open-make/airtrack-doc-website/README.md

# A repository to create a website with a construction guidance for an Airtrack.
## This repository is based on the aquired knowledge in open-make/AIRtrack-rebuilt.
