open-make/airtrack-doc-website/electronic.md

# Electronics part 1: Set up of the wiring

{{BOM}}

## Wiring of devices 

- In order to connect the devices you need a circuit board, e.g. this [circuit board](electronic.yml#circuit_board){Qty:some}. 

- Further you need many jumper wires [jumper wires](electronic.yml#jumper_wires){Qty:many} to set up connections accordingly to the following circuit drawing. You need male, female and ordinary wires. 

- To clean up the pathing of cables you can use cable ties like, e.g. these [cable ties](connectors.yml#cable_tie){Qty:many} and fixate with that the cables at the [aluminium strut profile](framework.yml#20x20Rod).

-  You can use a large breadboard to keep a structure between the [Arduino Uno](electronic.yml#Arduino_Uno){Qty:1}, [capacitive sensor MPR121](electronic.yml#mpr121){Qty:1}, [Active Buzzer](electronic.yml#Keyes_KY-012){Qty:1} and [H bridge L293D](electronic.yml#L293D){Qty:1}.

#### Wiring configuration
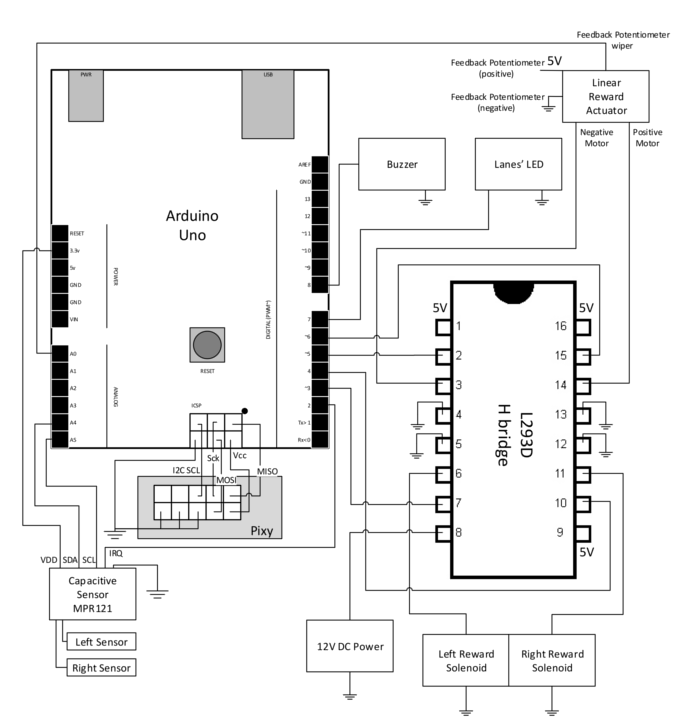
[picture p1: images/arduino_schematic.png]


#### Circuit boards with wiring configuration
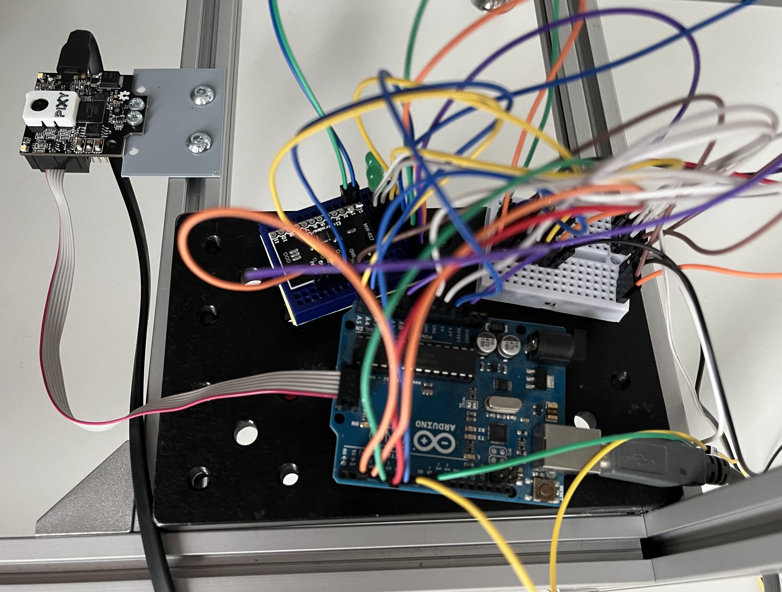
[picture p2: images/circuit.jpg]


### Component informations:

#### [H bridge L293D](electronic.yml#L293D):

- Each connection showing 5V must be connected with a 5V power supply. The Arduino Uno has a 5V power supply.

#### [Linear actuator](electronic.yml#LinActuator50mm):

- Orange cable – Feedback Potentiometer negative reference rail

- Purple cable – Feedback Potentiometer wiper

- Red cable – Motor V+ (6V or 12V)

- Black cable – Motor V- (Ground)

- Yellow cable – Feedback Potentiometer positive reference rail

#### [PixyCam2](electronic.yml#PixyCam)

- You should use the SPI cable to connect the [PixyCam2](electronic.yml#PixyCam) with the Arduino.
    - It should be included in the delivery

- The PixyCam needs to be connected the hole time for power supply

#### 12V Power supply

We used an DIY approach to connect a 12V power supply. It is shown in the picture below:

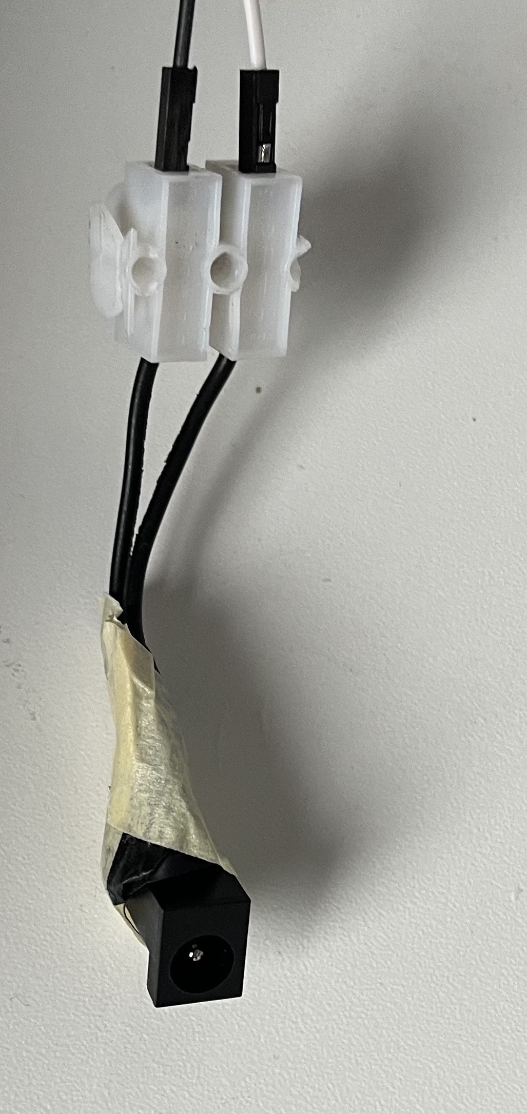
[picture p3: images/power_supply.jpg]


The black ending was removed from another electronic device with a 12V power supply. By this we can connect the power supply with the circuit board via cable.

#### [Capacitive sensor MPR121](electronic.yml#mpr121) 

The left and right sensor in the circuit diagram is meant to be a electrically conductive wire which is attached to each needle.

- The wire needs to be wrapped around the needle multiple times
    - For small changes in the placement of the wire the threshold of the Mpr121 needs to be adjusted. 

- The connections at the MPR121 must be soldered. Therefore you need a small [soldering station](tools.yml#soldering){Qty: 1, Cat: Tool}.

## Not required parts of wiring configuration 

The buzzer and LED in the wiring configuration are components of the first use case and may not be required for your set up. 
Because the provided code is also from the first use case, both components still get mentioned here.
