open-make/airtrack-doc-website/headandcamera.md

# Peripherals part 1: Attaching the camera

This page presents how to set a pixie camera below the setup. The camera should be far enough to record the whole bottom of the air table box. 
{{BOM}}

## 3D print a small plate {pagestep}

- 3D print the following file: 
    - Settings: [i](3D_settings_plate.md)

- Alternatively you can use a 50mm x 30mm x 1,5mm plastic plate.



## Setup / placement {pagestep}
- Place the two [nut](connectors.yml#5mmNuts){Qty:2}s, which are already in the lower center [aluminium strut profile](framework.yml#20x20Rod), with a distance of 35 mm. 

#### Placement of nuts in lower center strut

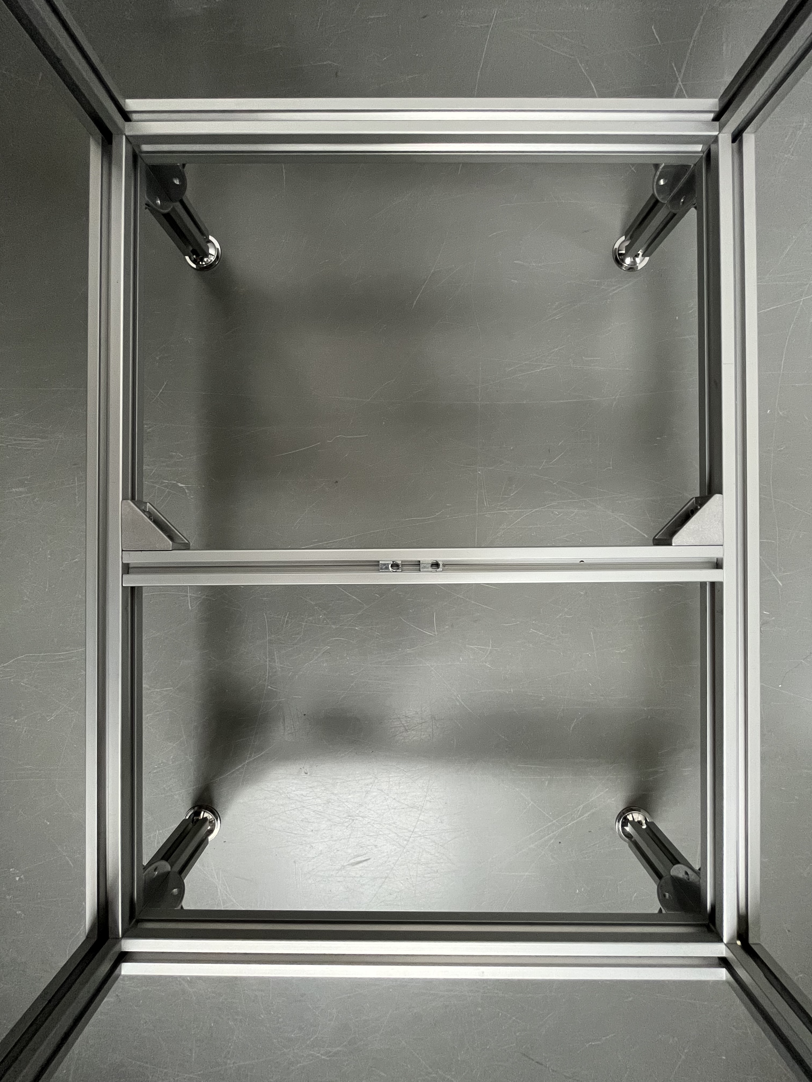
[picture p4: images/camera_below02.jpeg]


- Mark two points with the distance of the threads on the 1.5mm 3D printed plate along one long side with 5 to 10 mm distance from the edge. 

- Drill holes with a [5mm drill](tools.yml#5mmdrill){qty:1, Cat:tool} at both places.

- Take the [Pixy Camera](electronic.yml#PixyCam){qty:1} to mark on the other long side two more drill places with the distance of both holes from the fixation part of the [Pixy Camera](electronic.yml#PixyCam). The distance should be around 7 mm.

- Drill holes with a [3mm drill](tools.yml#3mmdrill){qty:1, Cat:tool} at both places.

- Connect the 3.5mm plate by using [M5 screw (6mm)](screws.yml#m5x6mm_screw){Qty: 2} with the [aluminium strut profile](framework.yml#20x20Rod).

- Connect the [Pixy Camera](electronic.yml#PixyCam) to the 1.5mm plate by using [M3 screw (5mm)](screws.yml#m3x5mm_screw){Qty: 2} and [M3 hexagon nut](screws.yml#m3_hexagon_nuts){Qty: 2}s.

>i **Note** 
>i
>i The [Pixy Camera](electronic.yml#PixyCam) needs to face with the lens away from the side of the table the rewards is provided from to have the assumed orientation of the script.

You might need to shift the [aluminium strut profile](framework.yml#20x20Rod) in the center a bit to have the [Pixy Camera](electronic.yml#PixyCam) in the center.

#### Picture of the below the table placed camera

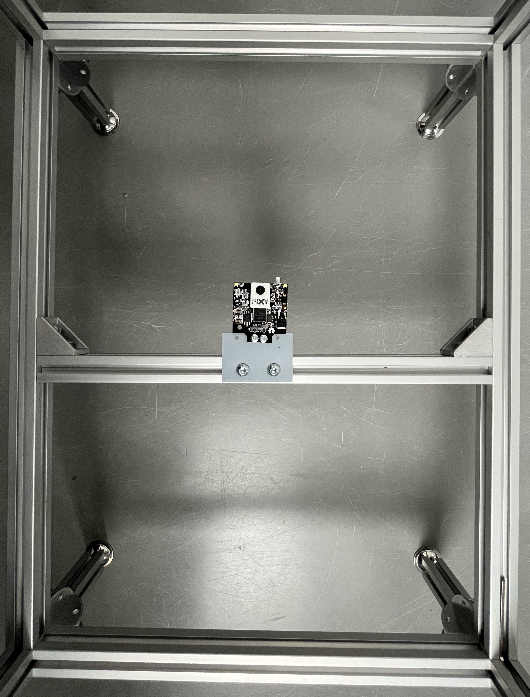
[picture p5: images/camera_below.jpeg]
