open-make/airtrack-doc-website/index.md

# Construct your Airtrack setup !

This website will guide you through the whole process of building an Airtrack setup (large platform version).

The Airtrack was first published in 2016, with a paper titled [Air-Track: a real-world floating environment for active sensing in head-fixed mice](https://doi.org/10.1152/jn.00088.2016).
It was developed by the authors of the paper with the help of the Charité workshop (Alexander Schill).
This documentation website was created by Fabio Reeh and reviewed by Julien Colomb, based on the existing documentation and an own replica.


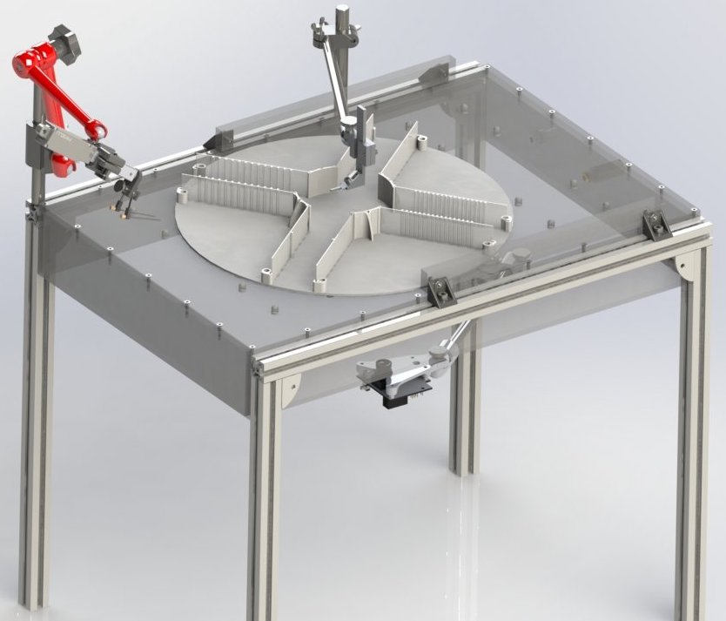
[picture p6: images/airtrack_platform_small.jpg]


This guide is part of the output from the [open.make project](https://www.openmake.de/) (see website for more information, including funding information). This project aims to further establish open hardware in academic research, and support
 scientist in the creation of FAIR research hardware.

## Table of contents

#### [Construction of the airtable](airtable.md){step}

#### [Precut of aluminium profile strut](precut.md){step}

#### [Predrill of plexiglass](predrill.md){step}

#### [Glue and screw](glue.md){step}

#### [Construction of the basic framework](basicframework.md){step}

#### [Insertion of ball valves](ballvalve.md){step}

#### [Air flow and pressure control](air_flow.md){step}

#### [Construction of the peripherals](peripherals.md){step}

#### [Construction of platform tracking](headandcamera.md){step}

#### [Construction of linear actuator front](actuator_head.md){step}

#### [Construction of the rewarding system](rewardsystem.md){step}

#### [Construction of the head fixation](headfixation.md){step}

#### [Floating platform](3Dprinting.md){step}

#### [Setup of the electronics](setup_electronic.md){step}

#### [Setup of the wiring](electronic.md){step}

#### [Installation of scripts](script_setup.md){step}

#### [Configuration of PixyCam](PixyCamConfig.md){step}

#### [Arduino code guide](code_usage.md){step}

#### [List of all necessary components]{BOM}

## About the Airtrack

To investigate the neuronal activities in ordinary behaviour, it's eligible to implement modern brain recording equipment.
These modern technics frequently require head fixation.
The Airtrack is one approach to facilitate analysing natural behaviour in its complexity.
Behaviour is depended on permanent sensory feedback from various modalities and to provide the possibility of sensory perception in its totality is a central challenge.
The Airtrack aims to facilitate these multiple sensory and motor modality approaches in combination with a simple setup, low costs and less computational processing.
The shift from a virtual visual (air ball/ treadmill with VR) to somatosensory modality approach causes a natural tactile representation while having less computational needs besides no errors between perception and movement of the mice and corresponding virtual environment.
The virtual environment approaches faces the difficulties of estimating the perceptual experience of the mice or other animals and it's probably impossible to match virtual reality and real world experience. 
The developers conclude that the Airtrack system is ideal for eliciting natural behaviour in concert with virtually any system for monitoring or manipulating brain activity.

The Airtrack was used to perform Go/No-Go and two-alternative forced choice tasks with mice.

As the system is in use within Larkum Lab and gets developed, we encourage you to check the recent publications to see new variants and applications.

## Overview of the setup

The airtrack system consists out of a central air table with the possibility of modification.
In this version, a mouse moves on a floating lightweight plus maze, while being head fixed in the center above the platform.
Below the table a camera tracks the movement of the plus maze with different coloring on the bottom side of the platform.
At one side of the table a moveable reward system is placed with two licking spots.
To detect if a spot was licked, a capacitive sensor is used.

The lanes on the maze are equipped with different features to distinguish them and correspond with the tasks. They can either be smooth or with gratings etched.
Further for the performed tasks, a LED and buzzer are installed to provide position feedback.
The position tracking was done with a Pixy camera (CMUcam5 Image Sensor) by detecting  different colouring on the bottom side of the plus maze.

The central table consists out of a plexiglass box with air flowing through. On the upper side many holes are placed to create an air cushion on the surface the platform can float on.
The table is mounted on aluminium legs to reach the desired height and space for the camera.
On the framework is a lot space to place e.g. further tracking devices.
The computational tasks are performed with a Arduino Uno microcontroller.

## Size and struts

The amount of strut profiles you need depends on the hight of the table, and how well you can cut the 2 m strut profiles into pieces. For the default table (height = 400 mm) it takes 6m (= 3 pieces). It is best practice to have more than you actually need, such that you get spares if the struts are incorrectly cut. 



### Download STEP file of hole Airtrack

The STL file above and the CAD files of the ZIP folder contain partly different components. The main changes:

- Platform borders
- Headfixation
- Camera mount
- No second framework ring

>i **Download** 
>i
>i Download all available CAD files and extra documents:
>i
>i Contains: STL file, CAD Parasolid file, CAD for SolidWorks viewer, STEP file, PDF with some technical aspects
>i
>i
>i [ZIP file](airtable_480x366.zip)
>i
>i **Note** 
>i
>i The STL and STEP files vary in the used components at some places to this guide

### Disclaimer: Construction complexity

Some parts are more difficult to construct than others. Mainly the central plexiglass box is difficult to build with an improvised work place. Precise cutting of the plexiglass is needed to ensure airtight manufacturing. Further, a workshop might use UV glue for the box which provides a higher quality.

If you have access to a workshop, we recommend you to get the air table constructed there. In general, it's better to have a large fraction of the Airtrack manufactured professionally. 

### Disclaimer: Arduino code complexity

I order to fully use the Airtrack, you need to debug and write code for the Arduino. The provided code works but you need to adjust it at some places to adapt it to your circumstances. 

### Advice: Further development

If you want to use the base hardware of the Airtrack and want to use it for other research questions, we recommend you to have a good understanding of the Arduino and possible peripherals. Besides you need sufficient coding experience with C++ (mostly used) to develop a good working code. 

References: [Nashaat MA, Oraby H, Sachdev RN, Winter Y, Larkum ME. Air-Track: a real-world floating environment for active sensing in head-fixed mice. J Neurophysiol. 116(4):1542-1553, 2016](https://pubmed.ncbi.nlm.nih.gov/27486102/)

#### Latest change: 24.10.2024
