open-make/airtrack-doc-website/headfixation.md

# Peripherals part 4: Construction of the head fixation 

For the observations the animal's head needs to be fixated above the center of the platform and therefore a head fixation method is required. This section is less detailed because you need to take your setup into account. Here we offer a solution which is basic and might work on your side. You can take this as an idea for the general basic structure if you design it yourself. In generell, we can recommend Thorlabs for ordering equipment.  

{{BOM}}

## Head fixation requirements

- Keep the head in one position centered above the table.
- The mouse needs to touch the ground in order to move the platform.

## Placing vertical mounting {pagestep}

- Place one free [nut](connectors.yml#5mmNuts) in each 480 mm [aluminium strut profile](framework.yml#20x20Rod){qty:2} of the [center air table](fromstep){Qty:1}, pointing upwards. 
     - The nut was placed in the step "Construction of the rewards system"

- Move the nuts to the center of the two 480 mm [aluminium strut profiles](framework.yml#20x20Rod).

- Place in each central nut one of the [M5 rods](framework.yml#M5Rod){Qty:2}. Attach on each [M5 rod](framework.yml#M5Rod) a [connecting clamp](connectors.yml#12mmCC){Qty:2} 150 mm  above the table. 

## Attaching the head fixation {pagestep}

- Turn both [connecting clamps](connectors.yml#12mmCC) on  the upwards pointing rods in a 90 degree angle. 

- Cut a 380 mm long piece of an  [aluminium rod 12mm diameter](framework.yml#12mmRod){Qty:1} with a [metall saw](tools.yml#metallsaw){Qty:1, cat: tool}, and place it in both [connecting clamps](connectors.yml#12mmCC) on the upwards pointing rods. On this rod attach the headfixation.

If the head fixation system you have is incompatible with this construction, a placement on the vertical [M5 thread rod](framework.yml#M5Rod) might work.

#### Picture of the rod above the table for the headfixation

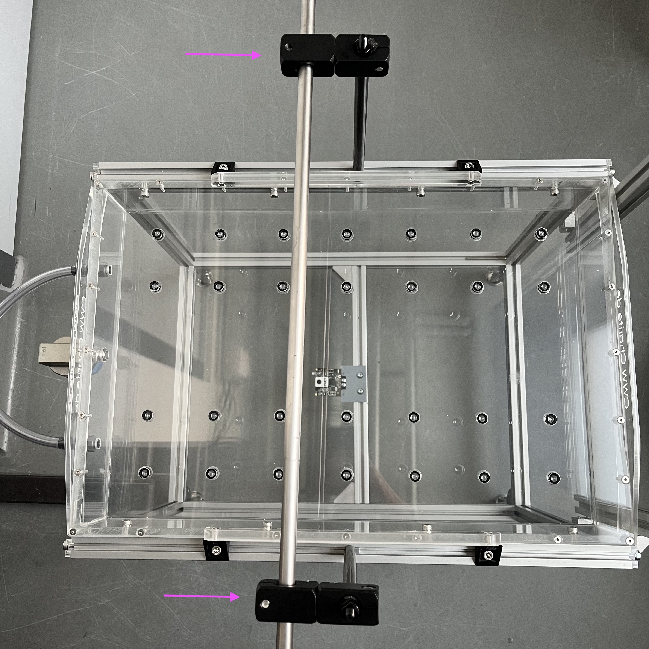
[picture p14: images/headfixation.jpeg]
