open-make/airtrack-doc-website/3D_settings_plate.md

# 3D print settings:

- Layer height: 0.2 mm 
- Infill: 60 % 
- Support: No
- Raft: if needed
