open-make/airtrack-doc-website/airtrack_platform.jpg

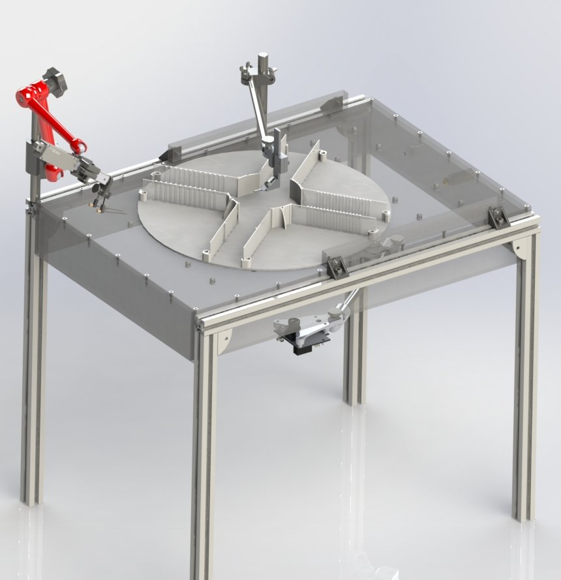
airtrack_platform.jpg
