open-make/airtrack-doc-website/images/desc_02.jpeg

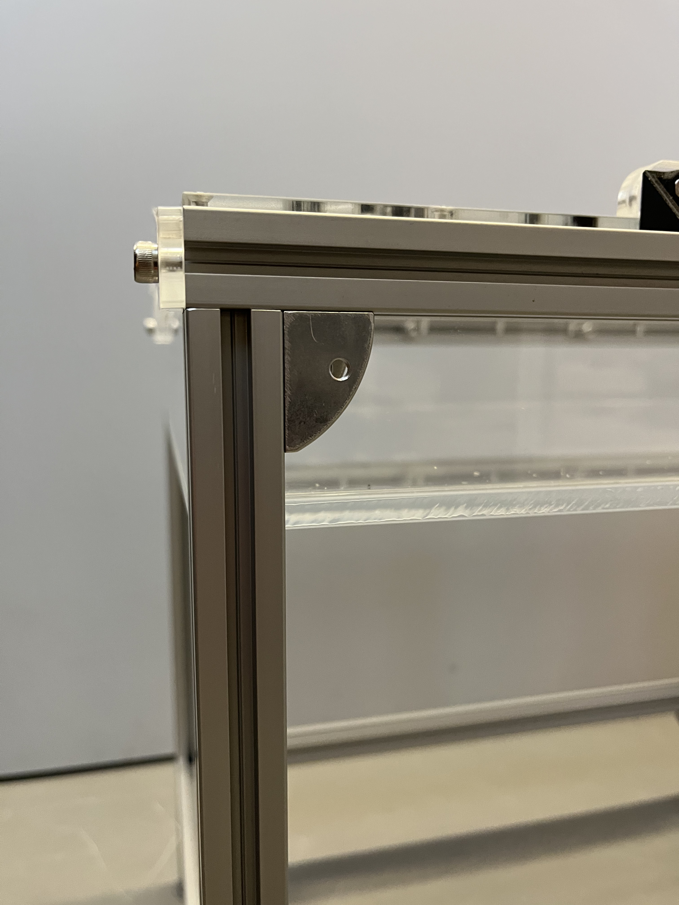
images/desc_02.jpeg
