open-make/airtrack-doc-website/images/desc_03.jpeg

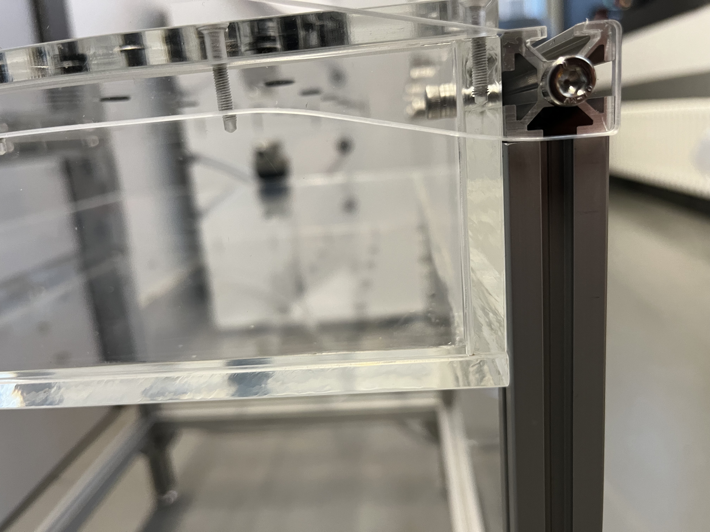
images/desc_03.jpeg
