open-make/airtrack-doc-website/images/desc_04.jpeg

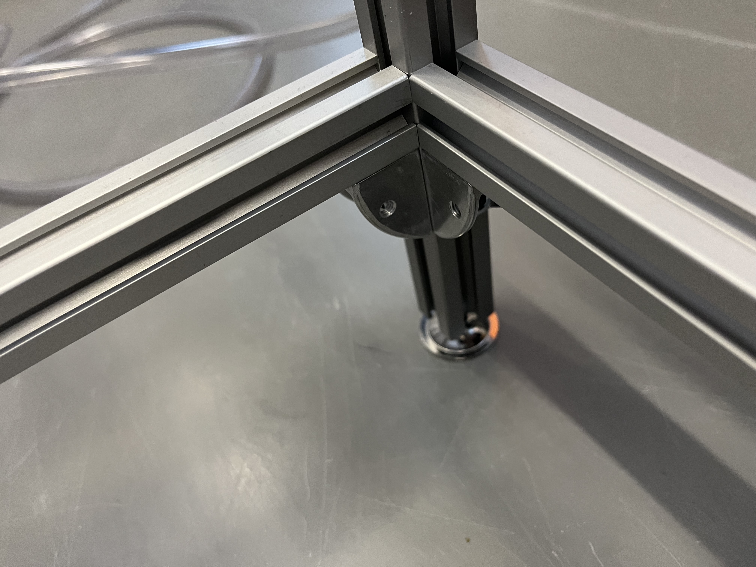
images/desc_04.jpeg
