open-make/airtrack-doc-website/images/platform_01.jpg

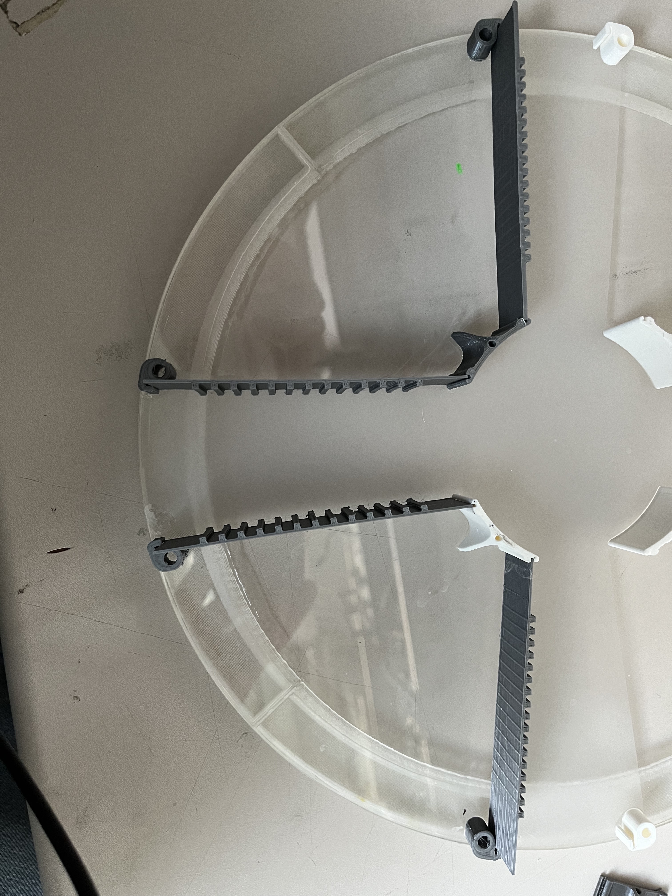
images/platform_01.jpg
