open-make/airtrack-doc-website/images/Top_plexiglas_drill_distances.jpeg

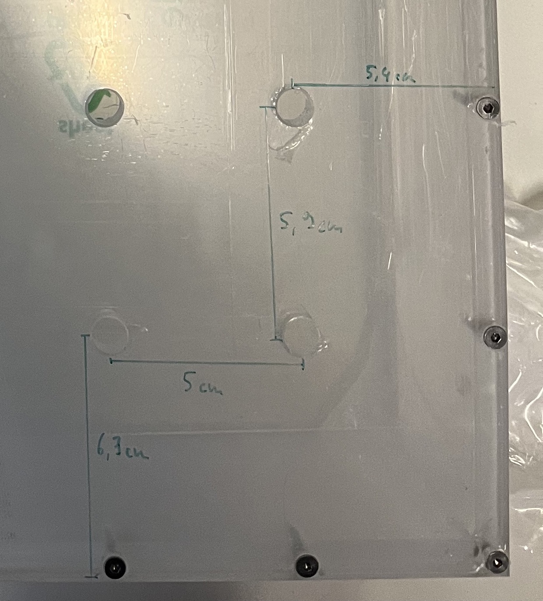
images/Top_plexiglas_drill_distances.jpeg
