open-make/airtrack-doc-website/models/ball_sleeve.stl

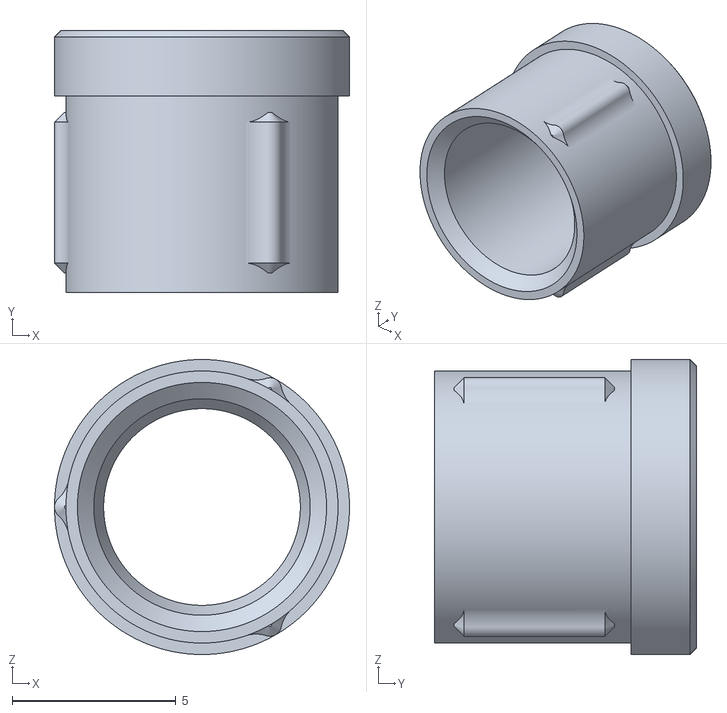
[picture p30: CAD file, 2024-09-29]
models/ball_sleeve.stl
9.00 x 8.00 x 9.00
