open-make/airtrack-doc-website/models/ball_fixation001.stl

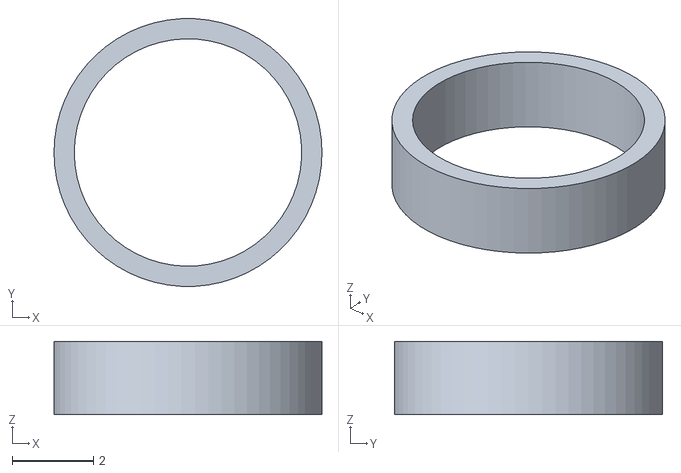
[picture p31: CAD file, 2024-09-29]
models/ball_fixation001.stl
6.60 x 6.59 x 1.80
