open-make/airtrack-doc-website/models/1_5mm_plate.stl

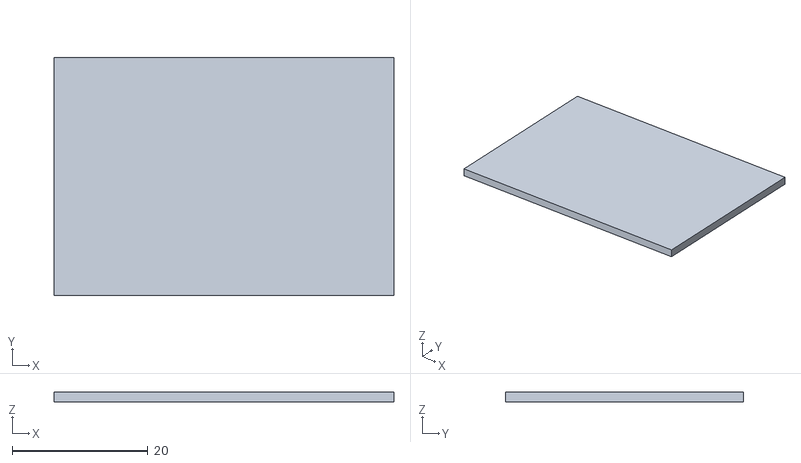
[picture p32: CAD file, 2023-10-10]
models/1_5mm_plate.stl
50.0 x 35.0 x 1.50
