open-make/airtrack-doc-website/models/l_maze_quarter_ground.stl

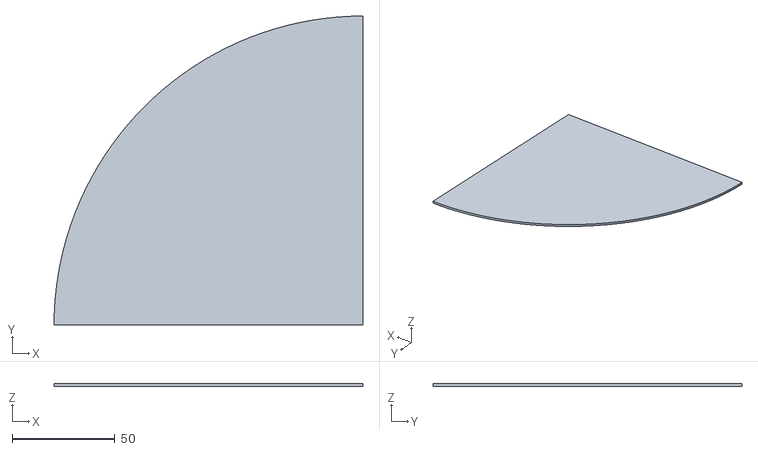
[picture p33: CAD file, 2023-09-13]
models/l_maze_quarter_ground.stl
150.0 x 150.0 x 1.50
