open-make/airtrack-doc-website/models/3_5mm_plate.stl

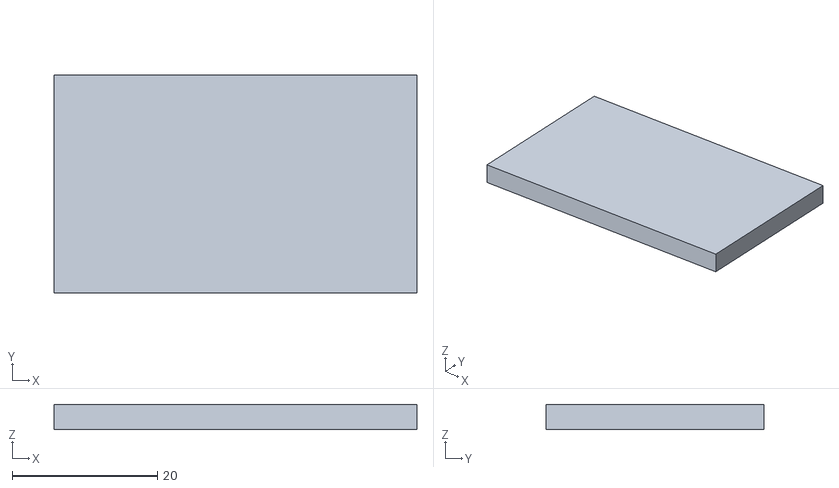
[picture p34: CAD file, 2023-06-09]
models/3_5mm_plate.stl
50.0 x 30.0 x 3.50
