open-make/airtrack-doc-website/models/rewards_moveable_needle_hold.stl

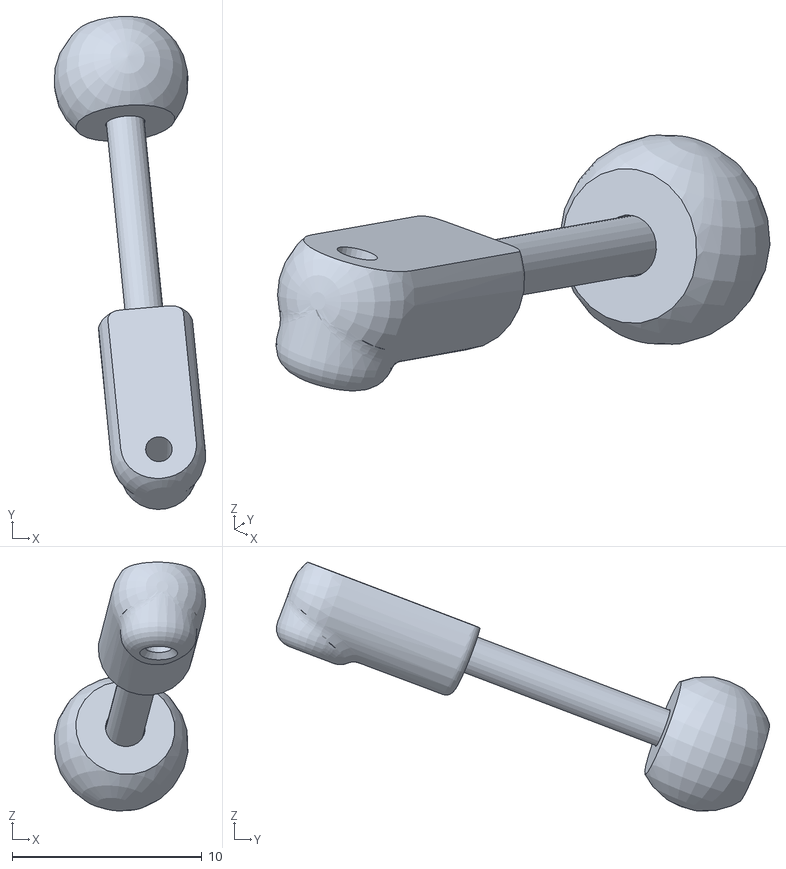
[picture p35: CAD file, 2023-06-09]
models/rewards_moveable_needle_hold.stl
7.96 x 26.0 x 13.1
