open-make/airtrack-doc-website/models/rewards_needle_fixation.stl

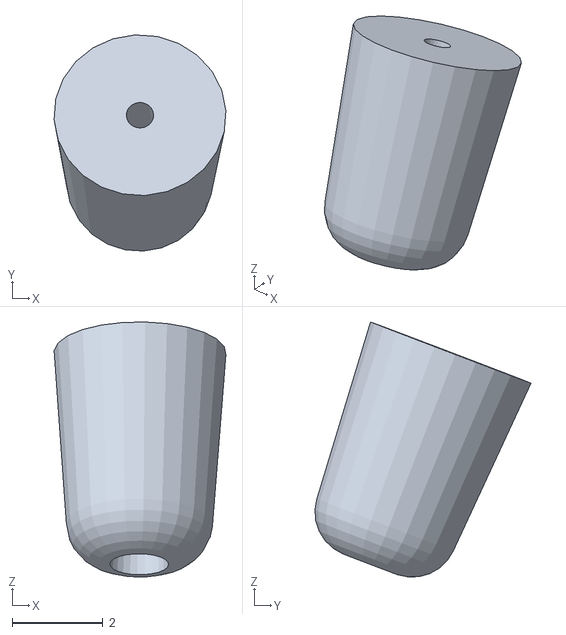
[picture p36: CAD file, 2023-06-09]
models/rewards_needle_fixation.stl
3.79 x 4.77 x 5.63
