open-make/airtrack-doc-website/models/rewards_mnh_end_02.stl

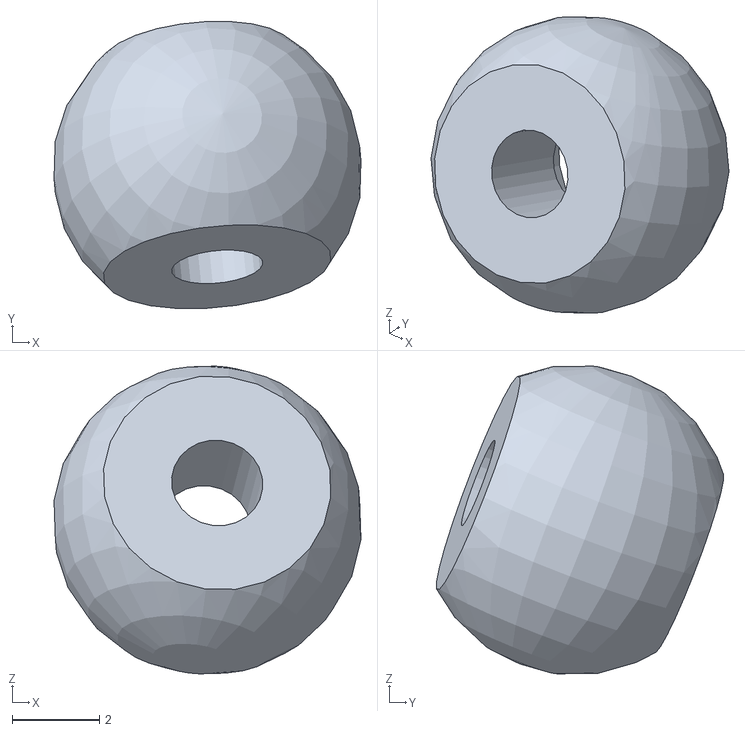
[picture p37: CAD file, 2023-06-09]
models/rewards_mnh_end_02.stl
7.03 x 6.57 x 7.04
