open-make/airtrack-doc-website/models/rewards_all.stl

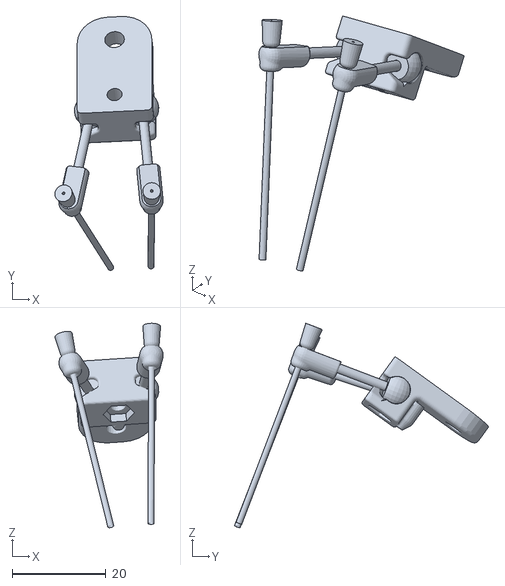
[picture p38: CAD file, 2023-06-09]
models/rewards_all.stl
23.1 x 54.2 x 43.7
