open-make/airtrack-doc-website/models/rewards_mnh_end_01001.stl

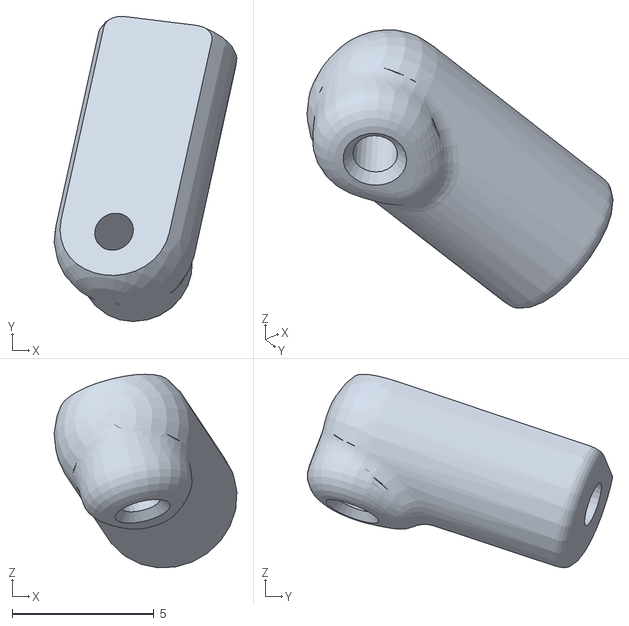
[picture p39: CAD file, 2023-06-09]
models/rewards_mnh_end_01001.stl
6.44 x 10.7 x 6.82
