open-make/airtrack-doc-website/models/rewards_center_01.stl

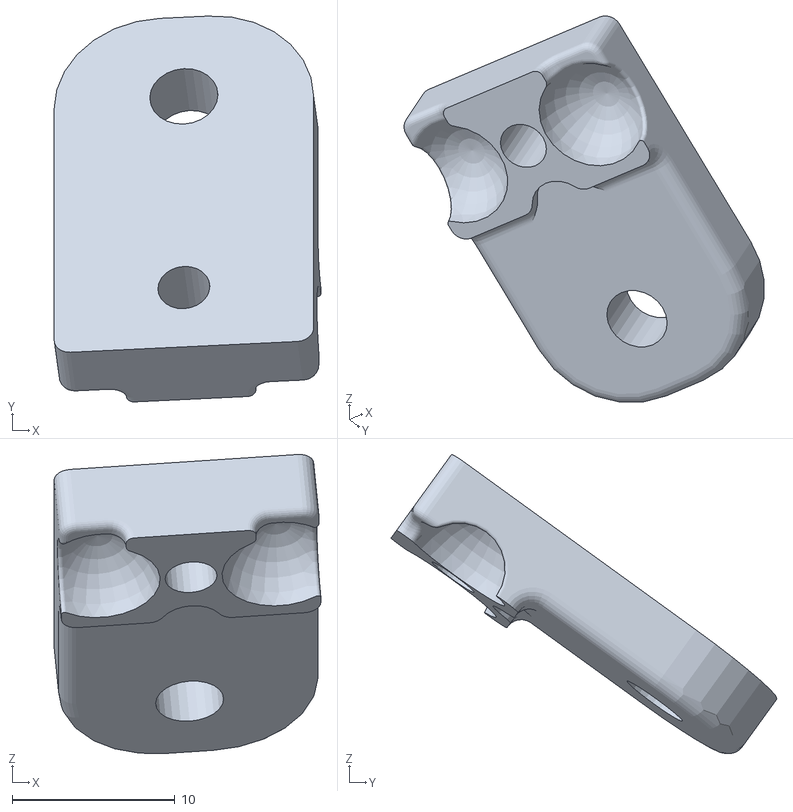
[picture p40: CAD file, 2023-06-09]
models/rewards_center_01.stl
16.4 x 23.7 x 18.4
