open-make/airtrack-doc-website/models/rewards_center_02.stl

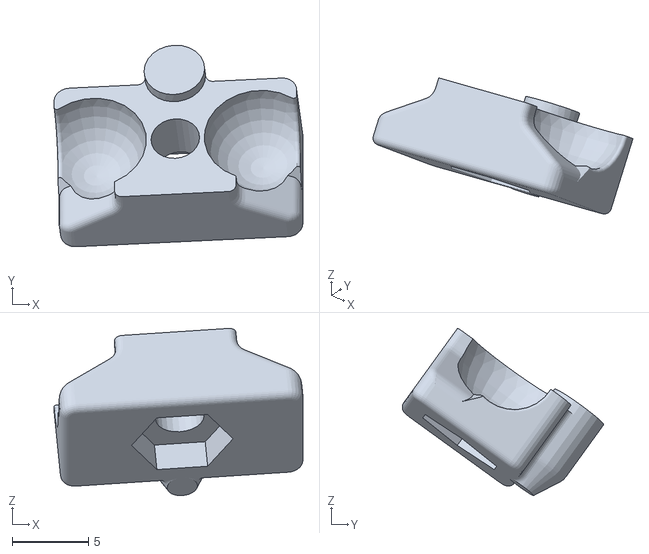
[picture p41: CAD file, 2023-06-09]
models/rewards_center_02.stl
16.4 x 13.2 x 11.0
