open-make/airtrack-doc-website/models/s_Maze_X_ground.stl

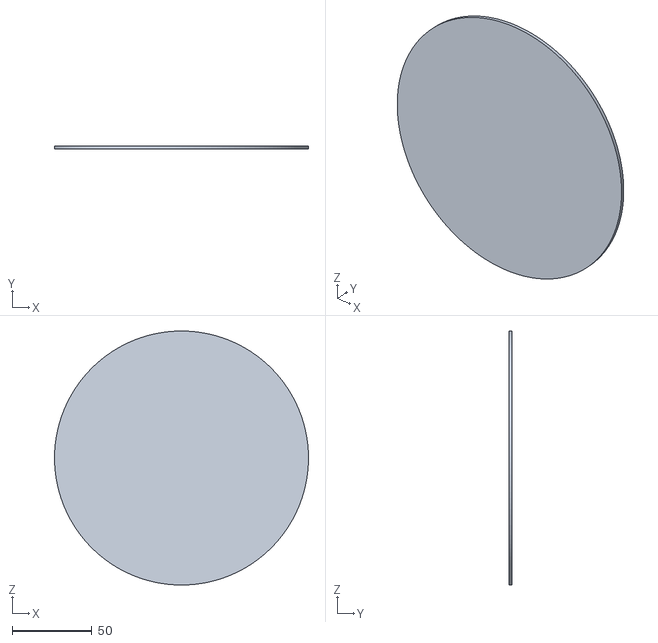
[picture p42: CAD file, 2023-01-26]
models/s_Maze_X_ground.stl
159.0 x 2.00 x 159.0
