open-make/airtrack-doc-website/models/s_Maze_walls.stl

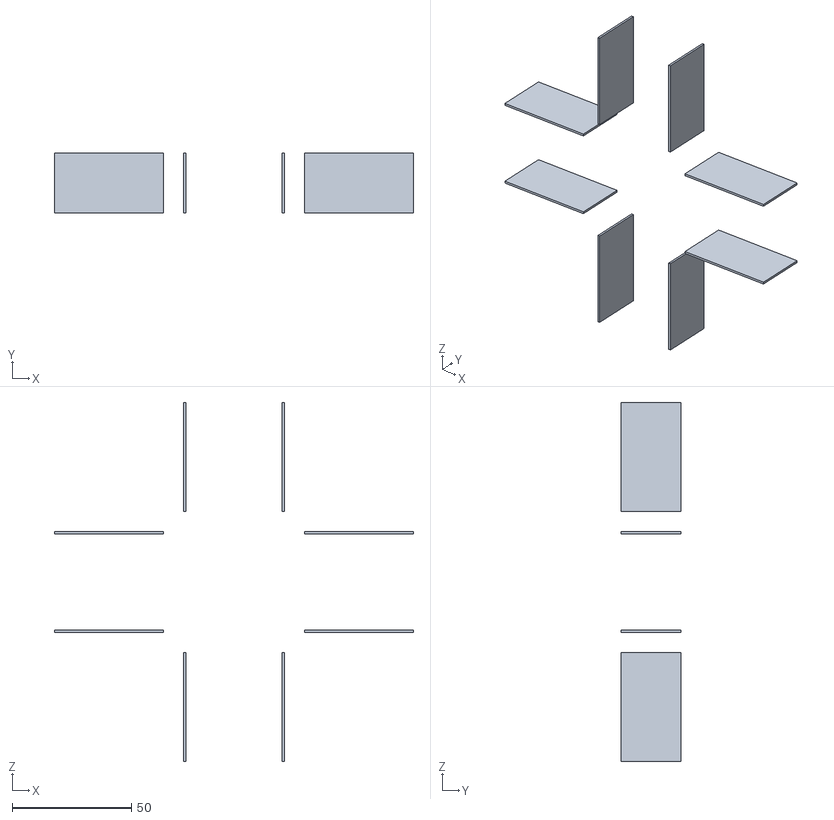
[picture p43: CAD file, 2023-01-26]
models/s_Maze_walls.stl
150.2 x 25.0 x 150.2
