open-make/airtrack-doc-website/models/l_Maze_X_wallmount.stl

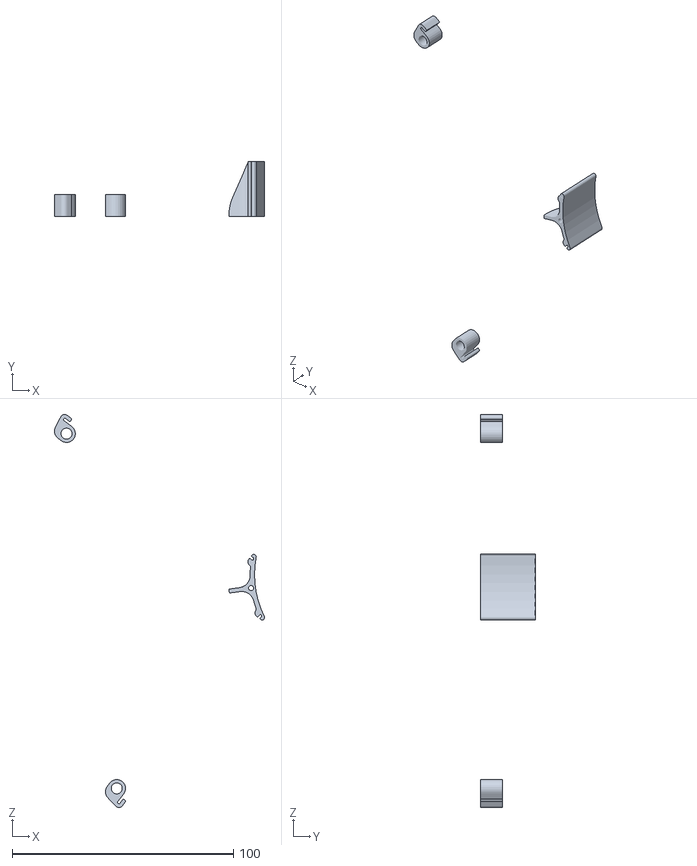
[picture p44: CAD file, 2023-01-26]
models/l_Maze_X_wallmount.stl
95.1 x 25.0 x 177.8
