open-make/airtrack-doc-website/models/s_Mazewall_mount.stl

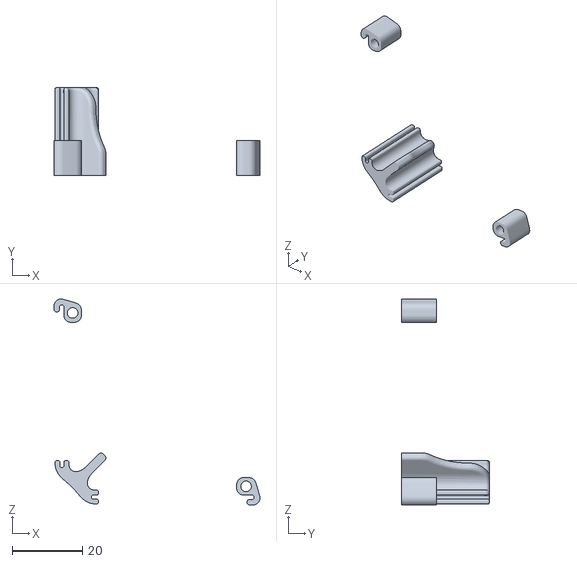
[picture p45: CAD file, 2023-01-26]
models/s_Mazewall_mount.stl
58.6 x 25.0 x 58.6
