open-make/airtrack-doc-website/models/s_Maze_X_rim.stl

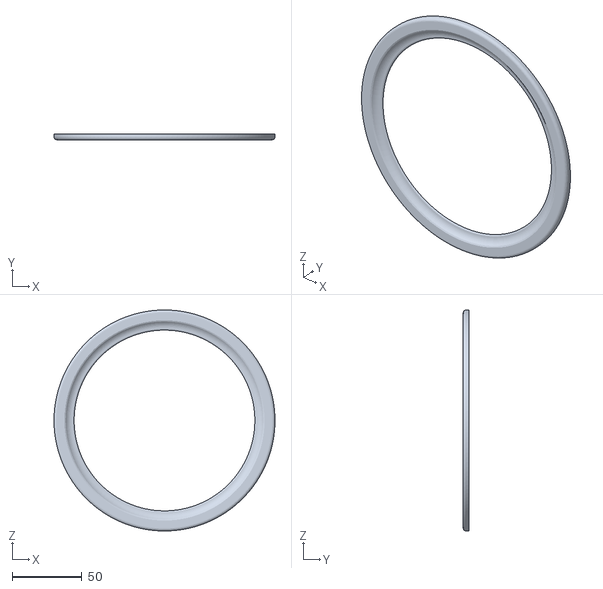
[picture p46: CAD file, 2023-01-26]
models/s_Maze_X_rim.stl
159.0 x 4.00 x 159.0
