open-make/airtrack-doc-website/models/s_Maze_X_all.stl

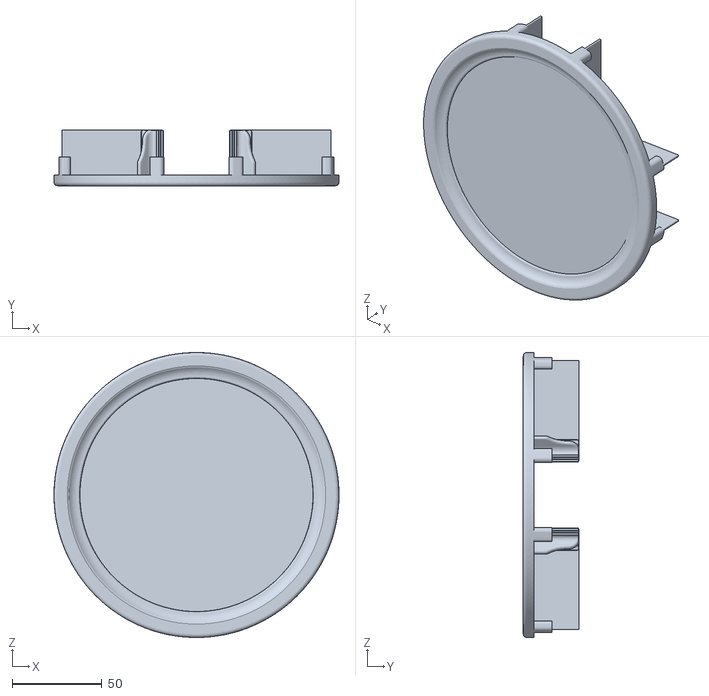
[picture p47: CAD file, 2023-01-23]
models/s_Maze_X_all.stl
159.0 x 31.0 x 159.0
