open-make/airtrack-doc-website/models/l_Maze_X_ground.stl

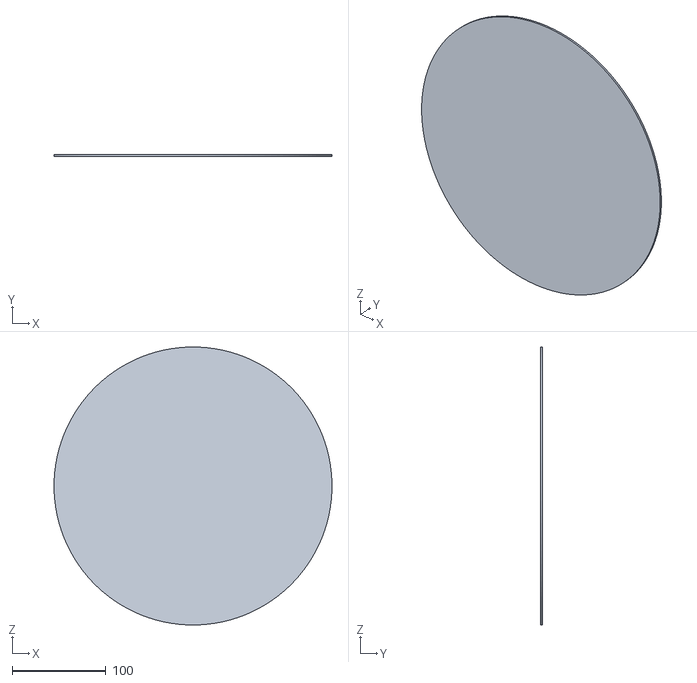
[picture p48: CAD file, 2023-01-23]
models/l_Maze_X_ground.stl
297.0 x 2.00 x 297.0
