open-make/airtrack-doc-website/models/l_Maze_all.stl

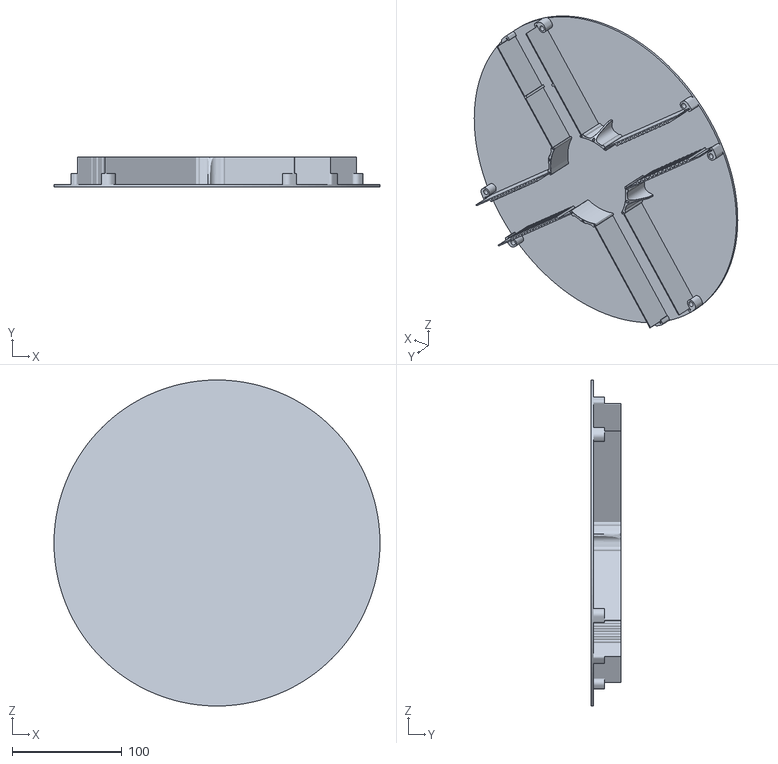
[picture p49: CAD file, 2023-01-23]
models/l_Maze_all.stl
297.0 x 27.0 x 297.0
