open-make/airtrack-doc-website/models/l_Maze_X_all_02.stl

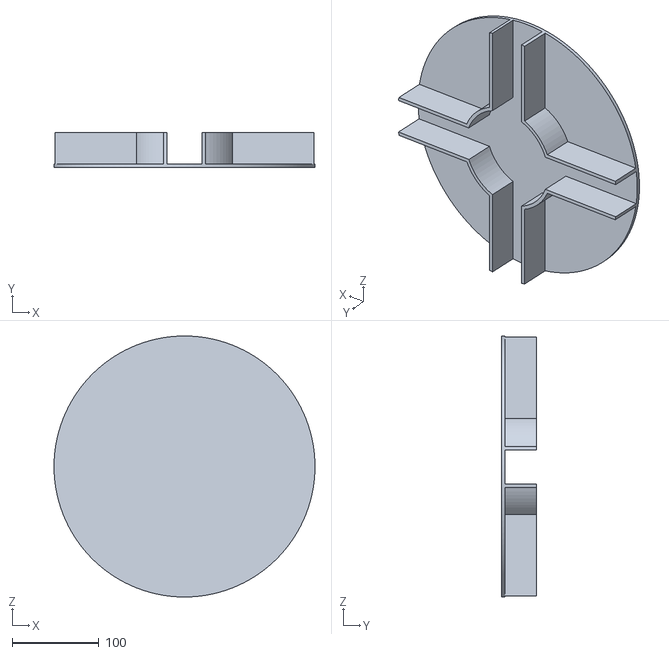
[picture p50: CAD file, 2023-01-23]
models/l_Maze_X_all_02.stl
300.0 x 40.0 x 300.0
