open-make/airtrack-doc-website/models/l_Maze_X_walls.stl

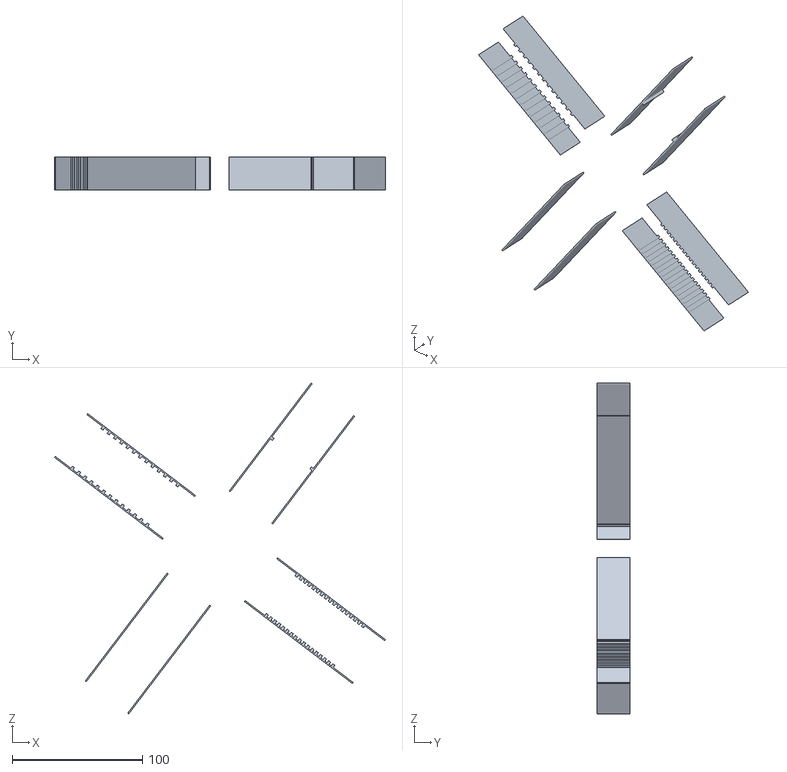
[picture p51: CAD file, 2023-01-23]
models/l_Maze_X_walls.stl
253.9 x 25.0 x 253.8
