open-make/airtrack-doc-website/setup_electronic.md

# Set up of the electronics

For full functionality a program is needed to control the devices and manage their actions in time. Before you need to connect the electronic devices and configure some settings. Some of the settings depend on circumstances on your side and parameters need to be evaluated by you.

## Wiring {pagestep}

Follow the [instruction](electronic.md) to connect the devices with the Arduino via circuit board.

## Uploading scripts {pagestep}

Follow the [instruction](script_setup.md) to upload the scripts to the Arduino.

## PixyCam configuration {pagestep}

Follow the [instruction](PixyCamConfig.md) to configure the PixyCam.

## Program {pagestep}

Read the [instruction](code_usage.md) to learn aspects of the scripts.
