open-make/airtrack-doc-website/guide_toDo.tsv

To do | Description | Done?
Angle | check at the workshop for the product info of the angles
Ball ventile | check at the workshop for the product info of the used ball ventiles
PixyCam Mount | Design 3D print | y
Linear Acuator | Design 3D print for front and back | y
licking spots | details needed | y
rewards supply | where to place the storage of rewads
