open-make/airtrack-doc-website/Constructional_drawing/short_sides_01.png

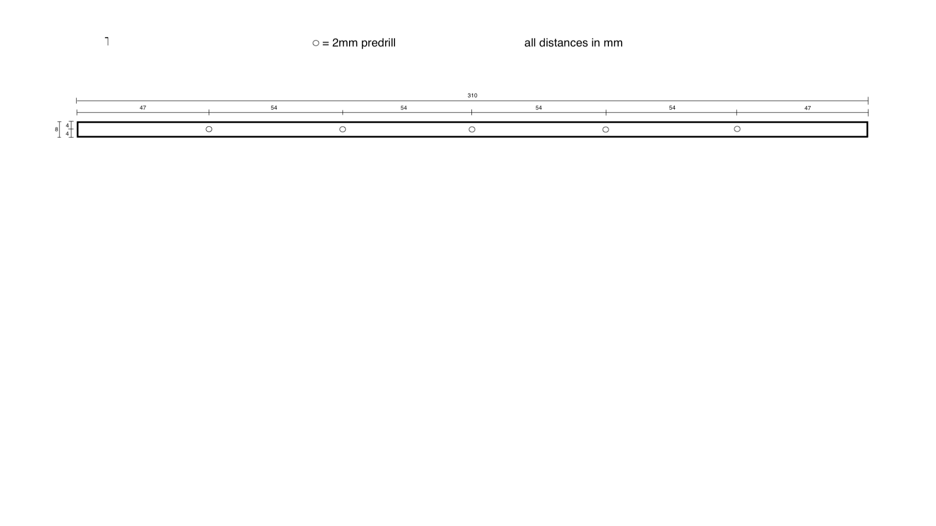
Constructional_drawing/short_sides_01.png
