open-make/airtrack-doc-website/Constructional_drawing/side_plates.png

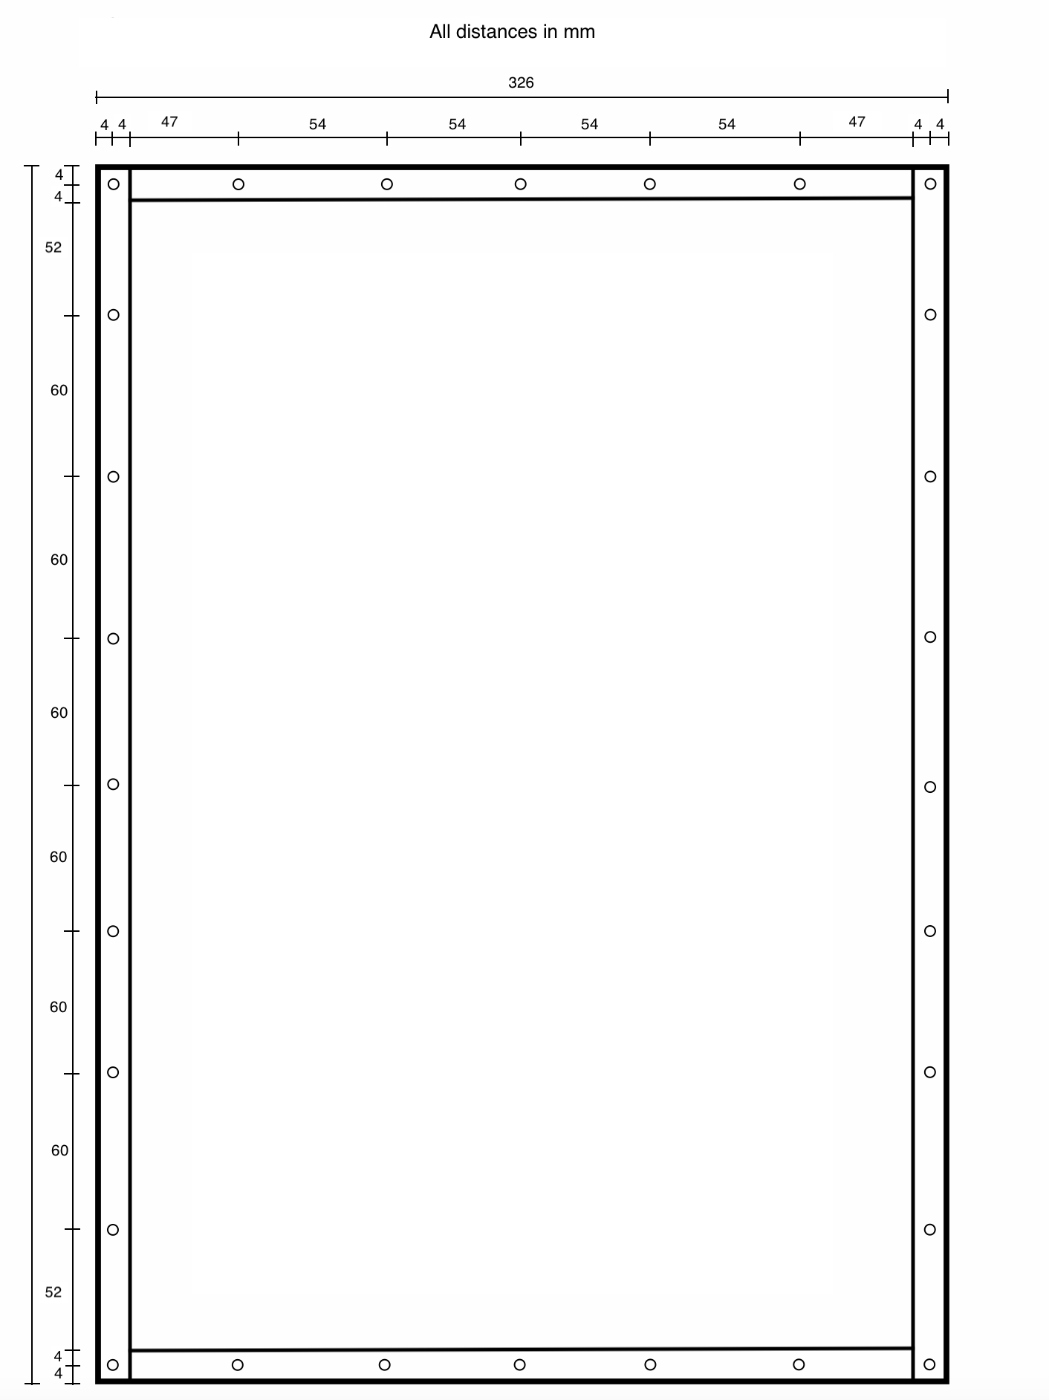
Constructional_drawing/side_plates.png
