open-make/airtrack-doc-website/(threads)

Thread 1 (2023-03-30):

todo list air track doc

jcolomb, 2023-03-30:
HARDWARE QUESTIONS
- [x] mpr placement + detectors placement + licking spots
- [x] pixy cam mount (extra 3d printing)
- [x] find a stable clamp for actuator
- [x] get info from workshop
     - balls and cylinder for balls
- [x] check English
- [x] better structure (group information in a way),  sub structure toc
- [x] review where we need (good) pictures

Closed 2024-05-08.

Thread 4 (2023-07-21):

to do

FabioReeh, 2023-07-21:
- [x] check order of logic (everywhere) -> glue bottom plate
- [ ] sub structure toc
- [x] disclaimer workshop append
- [x] every time use mm
- [x] why picture and wherefore -> caption
- [x]  add full length of frame
- [x] cutting guide frames and from this the amount

jcolomb, 2023-09-19:
moving to new todo

Closed 2023-09-19.

Thread 5 (2023-08-13):

to do

FabioReeh, 2023-08-13:
- [x] ground color
- [x] needle
- [x] head fixation
- [x] captions
- [x] 2nd variant plattform
- [x] reward liquid storage description

Closed 2023-11-14.
