open-make/airtrack-doc-website/plexiglass.yml

480x326pg:
    Name: (cast) acrylic glass sheet precut
    Description: 480mm x 326mm x 8mm
    Specs:
        Material: Polymethylmethacrylat



480x64pg:
    Name: (cast) acrylic glass sheet precut
    Description: 480mm x 64mm x 8mm
    Specs:
        Material: Polymethylmethacrylat



310x64pg:
    Name: (cast) acrylic glass sheet precut
    Description: 310mm x 64mm x 8mm
    Specs:
        Material: Polymethylmethacrylat

520x40pg:
    Name: (cast) acrylic glass sheet precut
    Description: 520mm x 40mm x 8mm
    Specs:
        Material: Polymethylmethacrylat

250x15pg:
    Name: (cast) acrylic glass sheet precut
    Description: 250mm x 15mm x 8mm
    Specs:
        Material: Polymethylmethacrylat

286x30pg:
    Name: (cast) acrylic glass sheet precut
    Description: 286mm x 30mm x 8mm
    Specs:
        Material: Polymethylmethacrylat

326x30pg:
    Name: (cast) acrylic glass sheet precut
    Description: 286mm x 30mm x 8mm
    Specs:
        Material: Polymethylmethacrylat

350x30pg:
    Name: Plexiglass precut
    Description: 350mm x 30mm x 8mm
    Specs:
        Material: Polymethylmethacrylat

366x30pg:
    Name: (cast) acrylic glass sheet precut
    Description: 366mm x 30mm x 8mm
    Specs:
        Material: Polymethylmethacrylat

r300mmpg:
    Name: Circular (cast) acrylic glass sheet precut
    Description: Diameter 300mm and height 4mm
    Specs:
        Material: Polymethylmethacrylat

ball:
    Name: Acrylic glass  
    Description: Acrylic glass XT ball, transparent, solid, diameter 6.4mm 
    Specs:
        Material: Acrylic glass 
    Suppliers:
        Modulor:
            PartNo: 0250311
            Link: 'https://www.modulor.de/en/acrylic-glass-xt-ball-transparent-solid-o-6-4-mm-oxid.html'
