open-make/airtrack-doc-website/(commit log)

2023-01-26 error fix
    [LMazeGroundandWall02_1.stl, PlusMazeWithoutWalls.stl, SMazeWithWalls.stl, SMazeWithoutWalls.stl, l_Maze X ground.stl, l_Maze X wall mount.stl, l_Maze all.stl, l_Maze x all 02.stl]
2023-06-09 push work
    [3_5mm_plate.stl, guide_toDo.tsv, rewards_all.stl, rewards_center_01.stl, rewards_center_02.stl, rewards_mnh_end_01.stl, rewards_mnh_end_01001.stl, rewards_mnh_end_02.stl]
2023-07-16 review drill and gluing
2023-07-16 review drill and gluing 2
2023-07-19 changing table of content and review framework and co...
2023-11-14 review started- until glue
2024-09-29 Add pictures and adjust pinch valves / tubes
    [ball_fixation.stl, ball_fixation001.stl, ball_sleeve.stl, ball_sleeve001.stl]
2024-10-17 Added pixy arduino library
2024-10-17 firewall Arduino ide note
