open-make/airtrack-doc-website/images/desc_06.jpeg

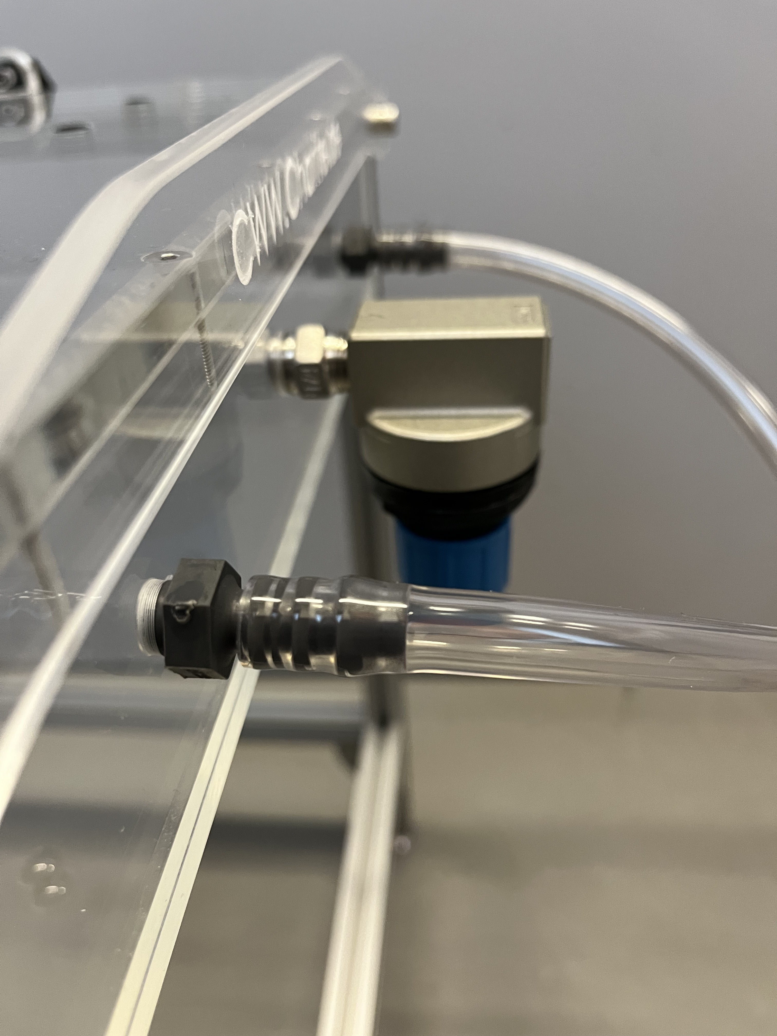
[picture p11: images/desc_06001.jpeg]
images/desc_06.jpeg
