open-make/airtrack-doc-website/images/desc_01.jpeg

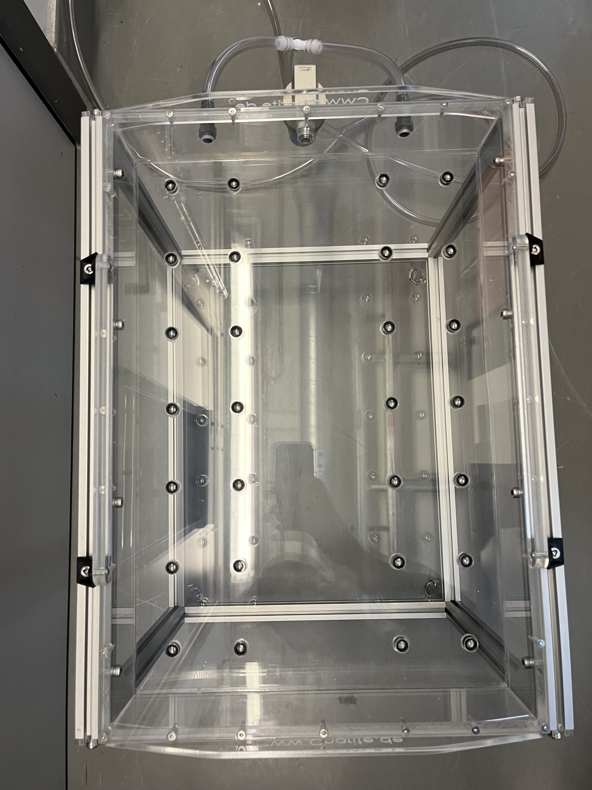
images/desc_01.jpeg
