open-make/airtrack-doc-website/images/Top_plexiglas_drill_distances_all.jpeg

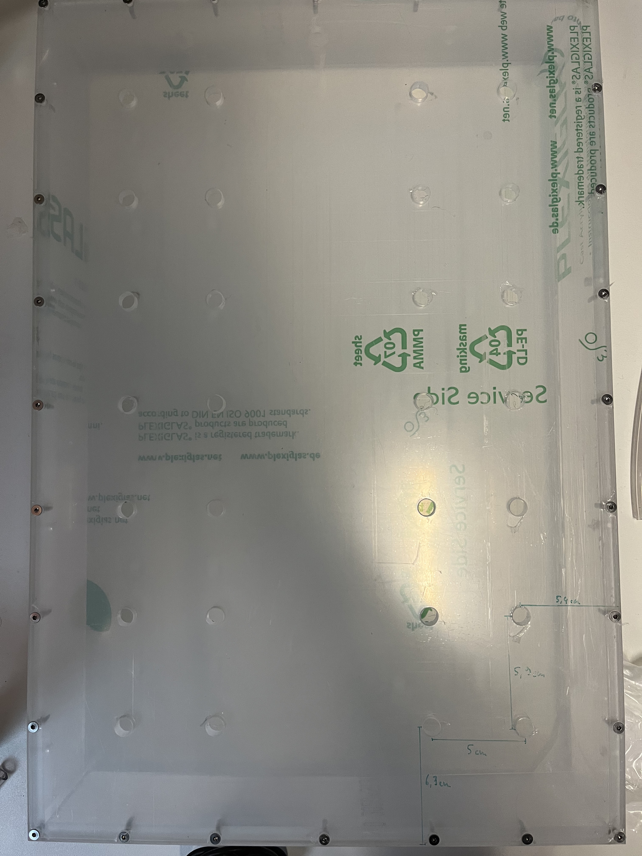
images/Top_plexiglas_drill_distances_all.jpeg
